greenenergyprojects/rpi-hot-water-controller/kicad/dist/rpi-hot-water-controller_image-top.png

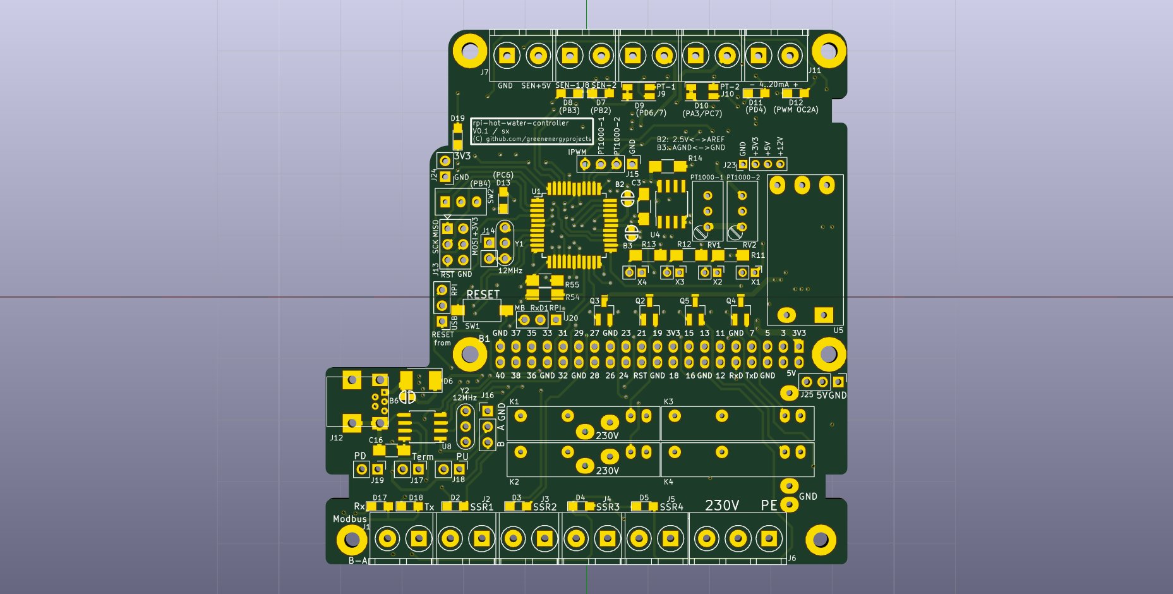
kicad/dist/rpi-hot-water-controller_image-top.png
