greenenergyprojects/rpi-hot-water-controller/kicad/dist/rpi-hot-water-controller_image-bottom.png

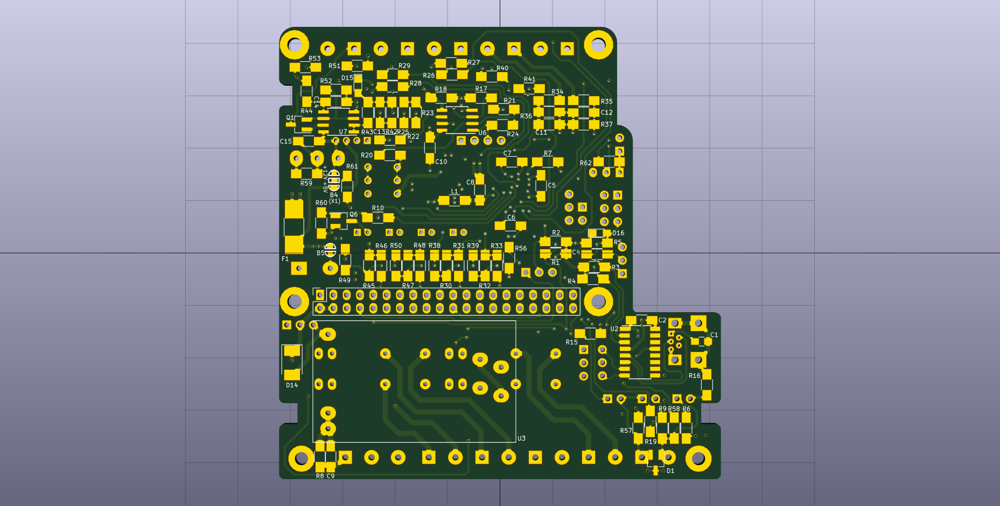
kicad/dist/rpi-hot-water-controller_image-bottom.png
