greenenergyprojects/rpi-hot-water-controller/kicad/README.md

https://rn-wissen.de/wiki/index.php/PTC/NTC#Schaltungsbeispiele
