greenenergyprojects/rpi-hot-water-controller/kicad/dist/rpi-hot-water-controller_bom.ods

Source: | /work/sx/gep/rpi-hot-water-controller/kicad/rpi-hot-water-controller.sch
Date: | Fr 12 Okt 2018 04:40:11 CEST
Tool: | Eeschema 4.0.7-e2-6376~61~ubuntu18.04.1
Component Count: | 159
Ref | Value | Footprint | Datasheet | Manufacturer | Vendor
B1 | SOLDERBRDIGE-3 | Pin_Headers:Pin_Header_Straight_1x03_Pitch2.54mm
B2 | SOLDERBRDIGE-2 | Project:SOLDER-JUMPER_1-WAY
B3 | SOLDERBRDIGE-2 | Project:SOLDER-JUMPER_1-WAY
B4 | SOLDERBRDIGE-3 | Project:SOLDER-JUMPER_2-WAY
B5 | SOLDERBRDIGE-2 | Project:SOLDER-JUMPER_1-WAY
B6 | SOLDERBRDIGE-2 | Project:SOLDER-JUMPER_1-WAY
C1 | 100n | Capacitors_SMD:C_0805_HandSoldering
C2 | 100n | Capacitors_SMD:C_1206_HandSoldering
C3 | 100n | Capacitors_SMD:C_1206_HandSoldering
C4 | 22n | Capacitors_SMD:C_1206_HandSoldering
C5 | 100n | Capacitors_SMD:C_1206_HandSoldering
C6 | 100n | Capacitors_SMD:C_1206_HandSoldering
C7 | 100n | Capacitors_SMD:C_1206_HandSoldering
C8 | 100n | Capacitors_SMD:C_1206_HandSoldering
C9 | 22n | Capacitors_SMD:C_1206_HandSoldering
C10 | 22n | Capacitors_SMD:C_1206_HandSoldering
C11 | 100n | Capacitors_SMD:C_1206_HandSoldering
C12 | 100n | Capacitors_SMD:C_1206_HandSoldering
C13 | 1u | Capacitors_SMD:C_1206_HandSoldering
C14 | 10u | Capacitors_SMD:C_1206_HandSoldering
C15 | 22n | Capacitors_SMD:C_1206_HandSoldering
C16 | 100n | Capacitors_SMD:C_1206_HandSoldering
D1 | D_TVS_x2_AAC-RESCUE-rpi-atmega324-modbus-x3-gateway | TO_SOT_Packages_SMD:SOT-23_Handsoldering
D2 | blue | LEDs:LED_0805_HandSoldering
D3 | blue | LEDs:LED_0805_HandSoldering
D4 | blue | LEDs:LED_0805_HandSoldering
D5 | blue | LEDs:LED_0805_HandSoldering
D6 | D_Schottky | Diodes_SMD:D_2114
D7 | green | LEDs:LED_0805_HandSoldering
D8 | green | LEDs:LED_0805_HandSoldering
D9 | PT1000-1 | Project:LED_Bi-Color-1206_ebay-381282302537
D10 | PT1000-2 | Project:LED_Bi-Color-1206_ebay-381282302537
D11 | green | LEDs:LED_0805_HandSoldering
D12 | blue | LEDs:LED_0805_HandSoldering
D13 | blue | LEDs:LED_0805_HandSoldering
D14 | D_Schottky | Diodes_SMD:D_2114
D15 | D_Schottky | LEDs:LED_0805_HandSoldering
D16 | D_Schottky | LEDs:LED_0805_HandSoldering
D17 | RX | LEDs:LED_0805_HandSoldering
D18 | TX | LEDs:LED_0805_HandSoldering
D19 | green | LEDs:LED_0805_HandSoldering
F1 | Polyfuse | Resistors_SMD:R_1812_HandSoldering
J1 | Modbus | Project:Terminalblock-2x-5,08mm_ebay-273426629807
J2 | SSR1 | Project:Terminalblock-2x-5,08mm_ebay-273426629807
J3 | SSR2 | Project:Terminalblock-2x-5,08mm_ebay-273426629807
J4 | SSR4 | Project:Terminalblock-2x-5,08mm_ebay-273426629807
J5 | SSR5 | Project:Terminalblock-2x-5,08mm_ebay-273426629807
J6 | Screw_Terminal_01x03 | Project:Terminalblock-3x-5mm_ebay-262602134567
J7 | SENSOR-SUPPLY | Project:Terminalblock-2x-5,08mm_ebay-273426629807
J8 | SENSOR-IN | Project:Terminalblock-2x-5,08mm_ebay-273426629807
J9 | PT1000-1 | Project:Terminalblock-2x-5,08mm_ebay-273426629807
J10 | PT1000-2 | Project:Terminalblock-2x-5,08mm_ebay-273426629807
J11 | 4-20mA | Project:Terminalblock-2x-5,08mm_ebay-273426629807
J12 | PRJ_USB_MINI | Project:USB_Mini-B-THT
J13 | Atmega-ISP-6 | Project:IDC_2x3x2.54mm_Straight
J14 | Conn_01x02 | Pin_Headers:Pin_Header_Straight_1x02_Pitch2.54mm
J15 | Conn_01x04 | Pin_Headers:Pin_Header_Straight_1x04_Pitch2.54mm
J16 | Conn_01x03 | Pin_Headers:Pin_Header_Straight_1x03_Pitch2.54mm
J17 | Conn_01x02 | Pin_Headers:Pin_Header_Straight_1x02_Pitch2.54mm
J18 | Conn_01x02 | Pin_Headers:Pin_Header_Straight_1x02_Pitch2.54mm
J19 | Conn_01x02 | Pin_Headers:Pin_Header_Straight_1x02_Pitch2.54mm
J20 | PRJ_Conn_01x03 | Pin_Headers:Pin_Header_Straight_1x03_Pitch2.54mm
J21 | Drill-1 | Mounting_Holes:MountingHole_2.5mm_Pad
J22 | Drill-2 | Mounting_Holes:MountingHole_2.5mm_Pad
J23 | Conn_01x04 | Pin_Headers:Pin_Header_Straight_1x04_Pitch2.00mm
J24 | TEST | Pin_Headers:Pin_Header_Straight_1x02_Pitch2.54mm
J25 | Conn_01x03 | Pin_Headers:Pin_Header_Straight_1x03_Pitch2.54mm
K1 | G3MB-202P | Project:SSR_Omron_G3MB-202P
K2 | G3MB-202P | Project:SSR_Omron_G3MB-202P
K3 | G3MB-202P | Project:SSR_Omron_G3MB-202P
K4 | G3MB-202P | Project:SSR_Omron_G3MB-202P
L1 | 10u | Inductors_SMD:L_1206_HandSoldering
P1 | PRJ_Raspberry_Pi_2+ | Project:PRJ_Raspberry-PI
Q1 | BSS138 | TO_SOT_Packages_SMD:SOT-23_Handsoldering
Q2 | BSS138 | TO_SOT_Packages_SMD:SOT-23_Handsoldering
Q3 | BSS138 | TO_SOT_Packages_SMD:SOT-23_Handsoldering
Q4 | BSS138 | TO_SOT_Packages_SMD:SOT-23_Handsoldering
Q5 | BSS138 | TO_SOT_Packages_SMD:SOT-23_Handsoldering
Q6 | BSS138 | TO_SOT_Packages_SMD:SOT-23_Handsoldering
R1 | 47k | Resistors_SMD:R_1206_HandSoldering
R2 | 47k | Resistors_SMD:R_1206_HandSoldering
R3 | 47k | Resistors_SMD:R_1206_HandSoldering
R4 | 47k | Resistors_SMD:R_1206_HandSoldering
R5 | 47k | Resistors_SMD:R_1206_HandSoldering
R6 | 560R | Resistors_SMD:R_1206_HandSoldering
R7 | 560R | Resistors_SMD:R_1206_HandSoldering
R8 | 100k | Resistors_SMD:R_1206_HandSoldering
R9 | 560R | Resistors_SMD:R_1206_HandSoldering
R10 | 220R | Resistors_SMD:R_1206_HandSoldering
R11 | 560R | Resistors_SMD:R_1206_HandSoldering
R12 | 560R | Resistors_SMD:R_1206_HandSoldering
R13 | 560R | Resistors_SMD:R_1206_HandSoldering
R14 | 330R | Resistors_SMD:R_1206_HandSoldering
R15 | 330R | Resistors_SMD:R_1206_HandSoldering
R16 | 330R | Resistors_SMD:R_1206_HandSoldering
R17 | 6k8 | Resistors_SMD:R_1206_HandSoldering
R18 | 8k2 | Resistors_SMD:R_1206_HandSoldering
R19 | 150R | Resistors_SMD:R_1206_HandSoldering
R20 | 2k7 | Resistors_SMD:R_1206_HandSoldering
R21 | 470R | Resistors_SMD:R_1206_HandSoldering
R22 | 6k8 | Resistors_SMD:R_1206_HandSoldering
R23 | 1k | Resistors_SMD:R_1206_HandSoldering
R24 | 15k | Resistors_SMD:R_1206_HandSoldering
R25 | 12k | Resistors_SMD:R_1206_HandSoldering
R26 | 820R | Resistors_SMD:R_1206_HandSoldering
R27 | 820R | Resistors_SMD:R_1206_HandSoldering
R28 | 820R | Resistors_SMD:R_1206_HandSoldering
R29 | 820R | Resistors_SMD:R_1206_HandSoldering
R30 | 220R | Resistors_SMD:R_1206_HandSoldering
R31 | 680R | Resistors_SMD:R_1206_HandSoldering
R32 | 220R | Resistors_SMD:R_1206_HandSoldering
R33 | 680R | Resistors_SMD:R_1206_HandSoldering
R34 | 4k7 | Resistors_SMD:R_1206_HandSoldering
R35 | 4k7 | Resistors_SMD:R_1206_HandSoldering
R36 | 8k2 | Resistors_SMD:R_1206_HandSoldering
R37 | 8k2 | Resistors_SMD:R_1206_HandSoldering
R38 | 47k | Resistors_SMD:R_1206_HandSoldering
R39 | 47k | Resistors_SMD:R_1206_HandSoldering
R40 | 680R | Resistors_SMD:R_1206_HandSoldering
R41 | 680R | Resistors_SMD:R_1206_HandSoldering
R42 | 3k3 | Resistors_SMD:R_1206_HandSoldering
R43 | 6k8 | Resistors_SMD:R_1206_HandSoldering
R44 | 15k | Resistors_SMD:R_1206_HandSoldering
R45 | 220R | Resistors_SMD:R_1206_HandSoldering
R46 | 680R | Resistors_SMD:R_1206_HandSoldering
R47 | 220R | Resistors_SMD:R_1206_HandSoldering
R48 | 680R | Resistors_SMD:R_1206_HandSoldering
R49 | 47k | Resistors_SMD:R_1206_HandSoldering
R50 | 47k | Resistors_SMD:R_1206_HandSoldering
R51 | 680R | Resistors_SMD:R_1206_HandSoldering
R52 | 120R | Resistors_SMD:R_1206_HandSoldering
R53 | 470 | Resistors_SMD:R_1206_HandSoldering
R54 | 47k | Resistors_SMD:R_1206_HandSoldering
R55 | 47k | Resistors_SMD:R_1206_HandSoldering
R56 | 47k | Resistors_SMD:R_1206_HandSoldering
R57 | 10R | Resistors_SMD:R_1206_HandSoldering
R58 | 10R | Resistors_SMD:R_1206_HandSoldering
R59 | 100k | Resistors_SMD:R_1206_HandSoldering
R60 | 47k | Resistors_SMD:R_1206_HandSoldering
R61 | 560R | Resistors_SMD:R_1206_HandSoldering
R62 | 680R | Resistors_SMD:R_1206_HandSoldering
RV1 | 1k | Potentiometers:Potentiometer_Trimmer_Bourns_3296W
RV2 | 1k | Potentiometers:Potentiometer_Trimmer_Bourns_3296W
SW1 | SW_Push | Project:PRJ_SW_SPST_FSMSM
SW2 | SW On/Off | Project:SW_ebay-171865305033
U1 | PRJ-UC-ATMEGA324P-20AU | Project:TQFP-44_10x10mm_Pitch0.8mm_Handsolded
U2 | CH340G | Project:SOIC-16_3.9x9.9mm_Pitch1.27mm_HANDSOLDERED
U3 | HLK-5M05 | Project:HLK_5M05
U4 | PRJ_LM336M-2.5 | Project:SOIC-8_3.9x4.9mm_Pitch1.27mm_Handsolded
U5 | PRJ-supply-5VtoPM12V_ebay-253052736386 | Project:ebay-253052736386
U6 | LM358 | Project:SOIC-8_3.9x4.9mm_Pitch1.27mm_Handsolded
U7 | LM358 | Project:SOIC-8_3.9x4.9mm_Pitch1.27mm_Handsolded
U8 | SN65HVD11 | Project:SOIC-8_3.9x4.9mm_Pitch1.27mm_Handsolded
X1 | EXT1 | Pin_Headers:Pin_Header_Straight_1x02_Pitch2.00mm
X2 | EXT2 | Pin_Headers:Pin_Header_Straight_1x02_Pitch2.00mm
X3 | EXT3 | Pin_Headers:Pin_Header_Straight_1x02_Pitch2.00mm
X4 | EXT4 | Pin_Headers:Pin_Header_Straight_1x02_Pitch2.00mm
Y1 | 12MHz | Crystals:Resonator-3pin_w7.0mm_h2.5mm
Y2 | 12MHz | Crystals:Resonator-3pin_w7.0mm_h2.5mm
