greenenergyprojects/rpi-hot-water-controller/kicad/dist/rpi-hot-water-controller_schematic-bw.pdf

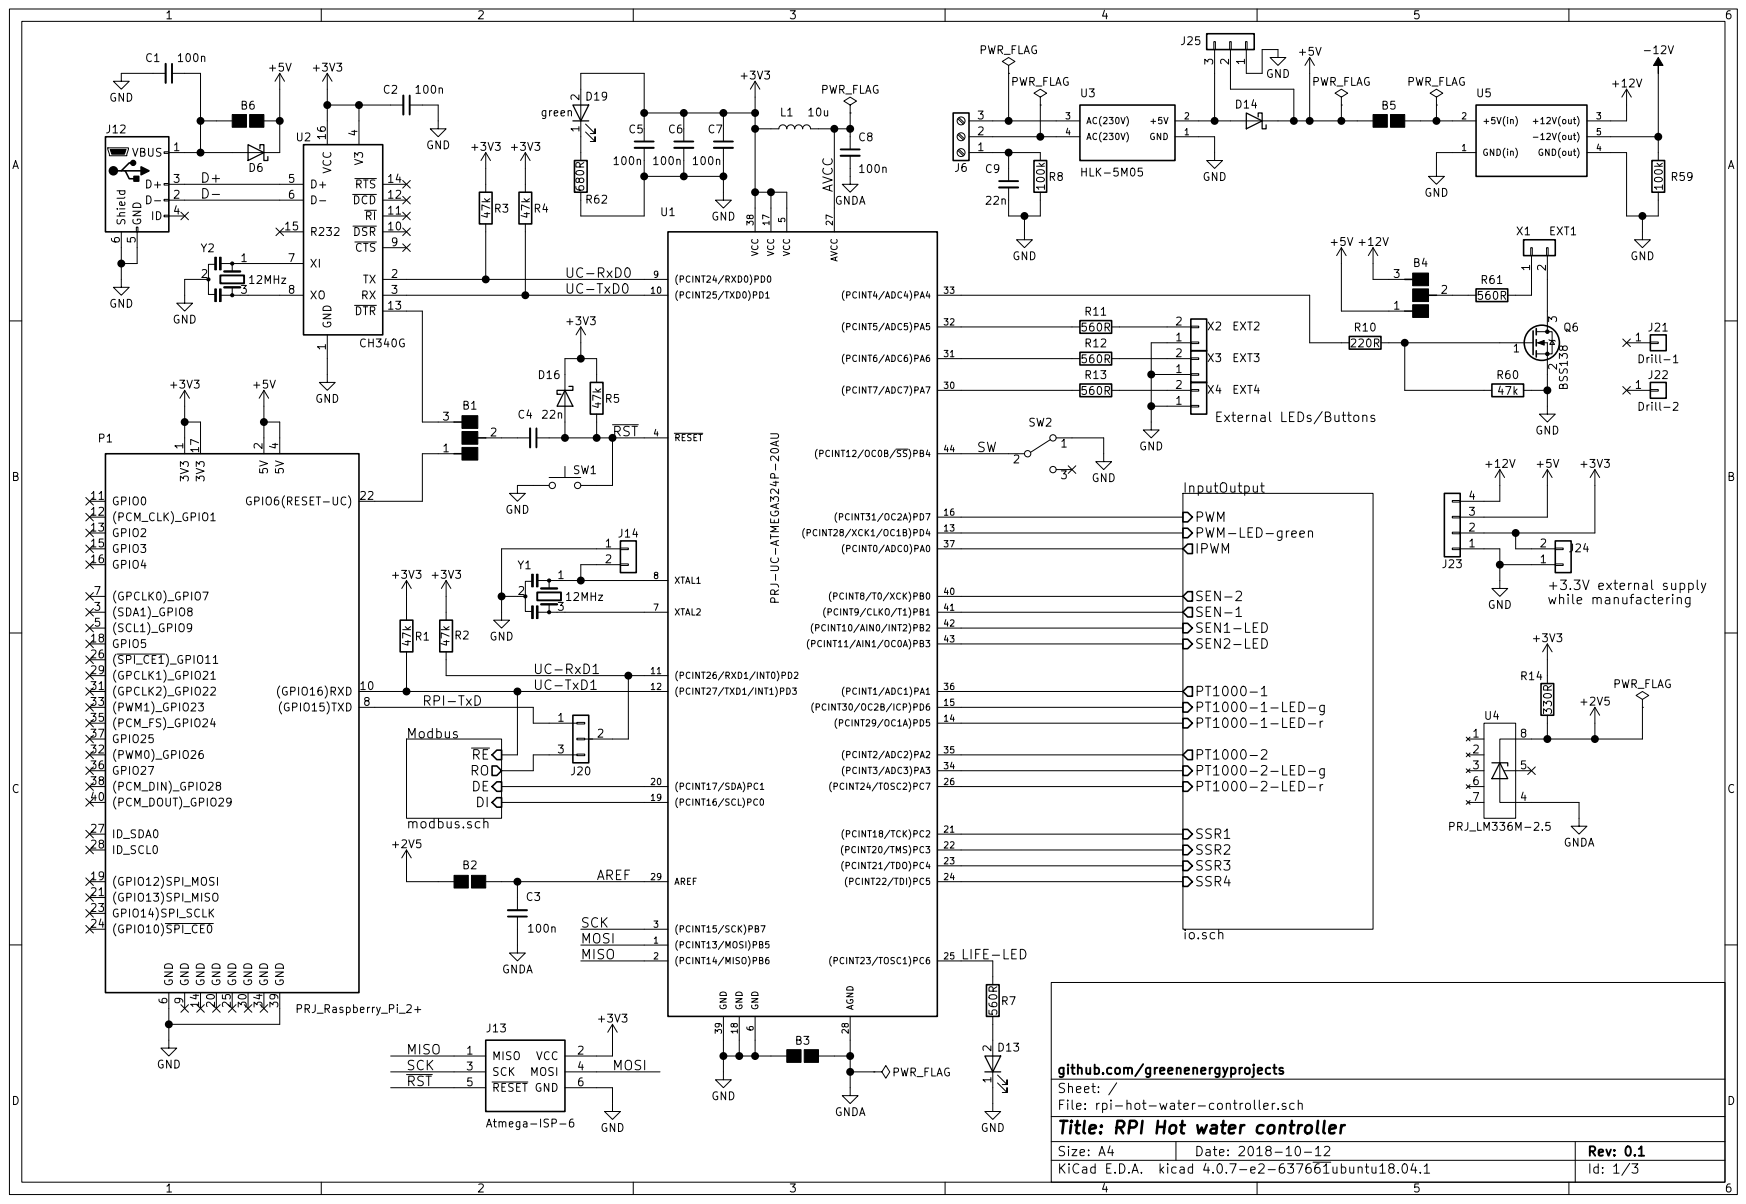
[picture p3: page 1]

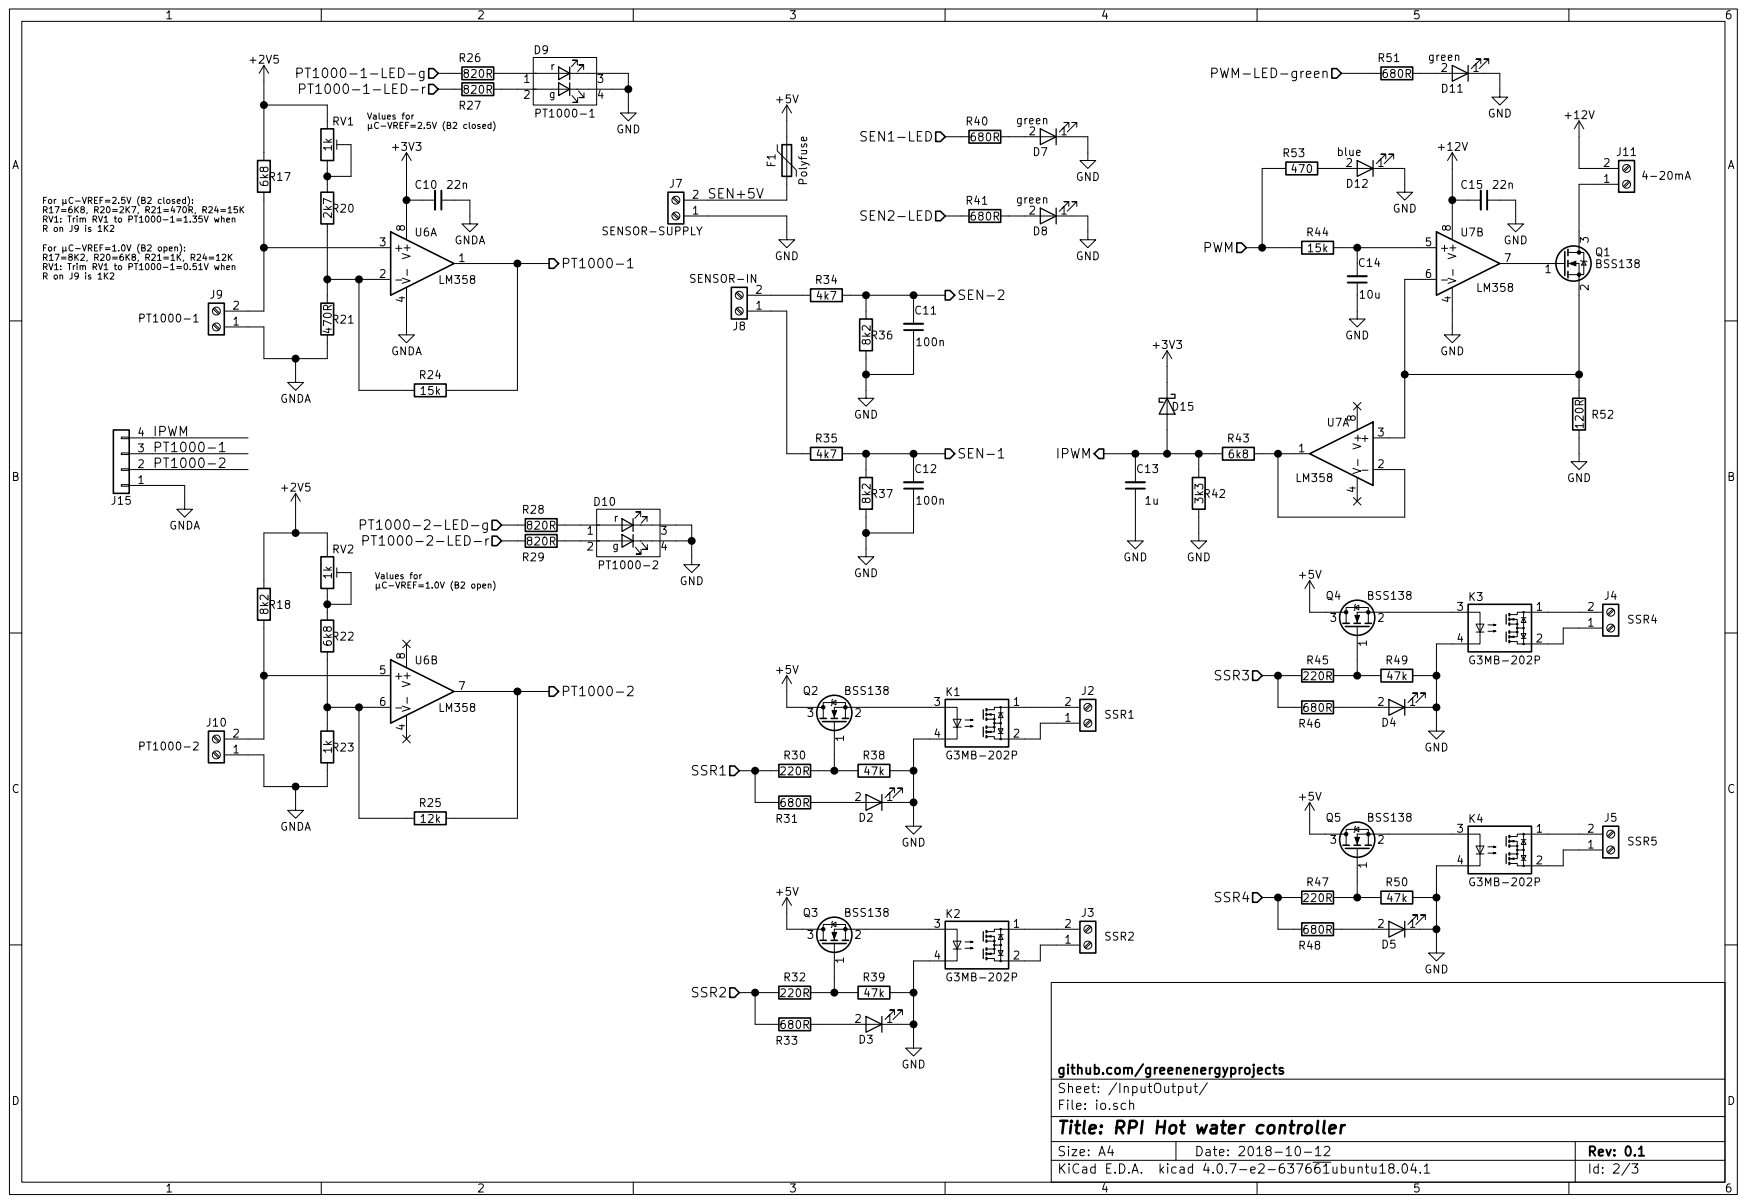
[picture p4: page 2]

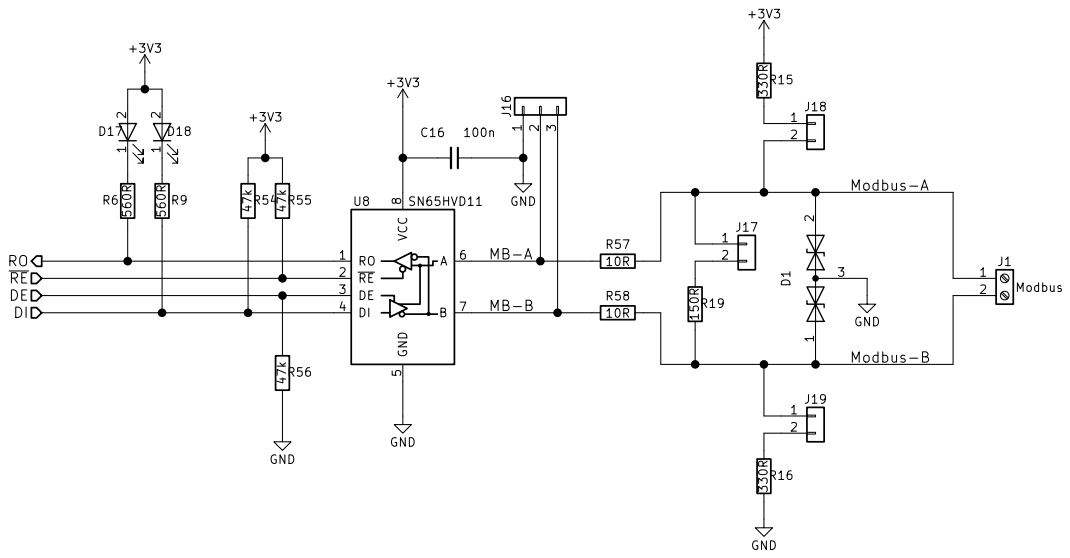
[picture p5: page 3]
