greenenergyprojects/rpi-hot-water-controller/kicad/dist/rpi-hot-water-controller_schematic.pdf

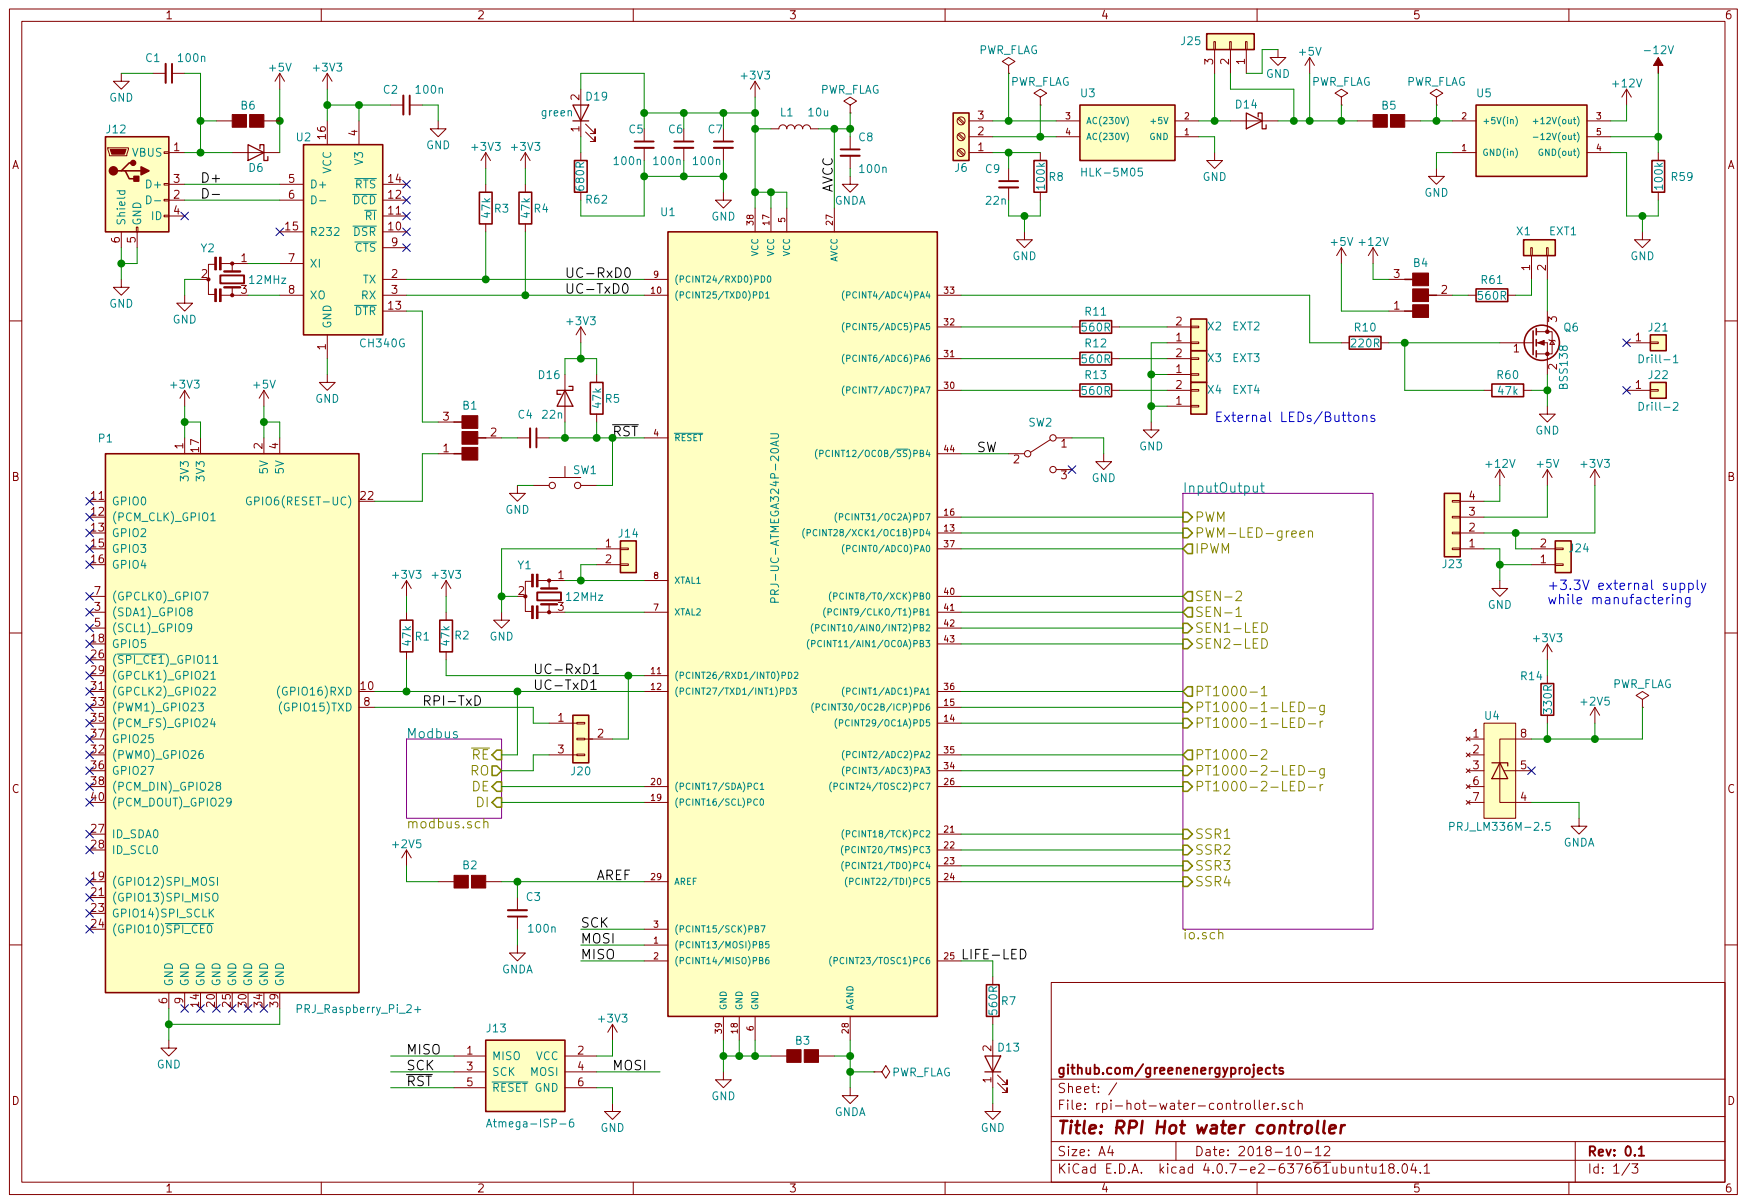
[picture p6: page 1]

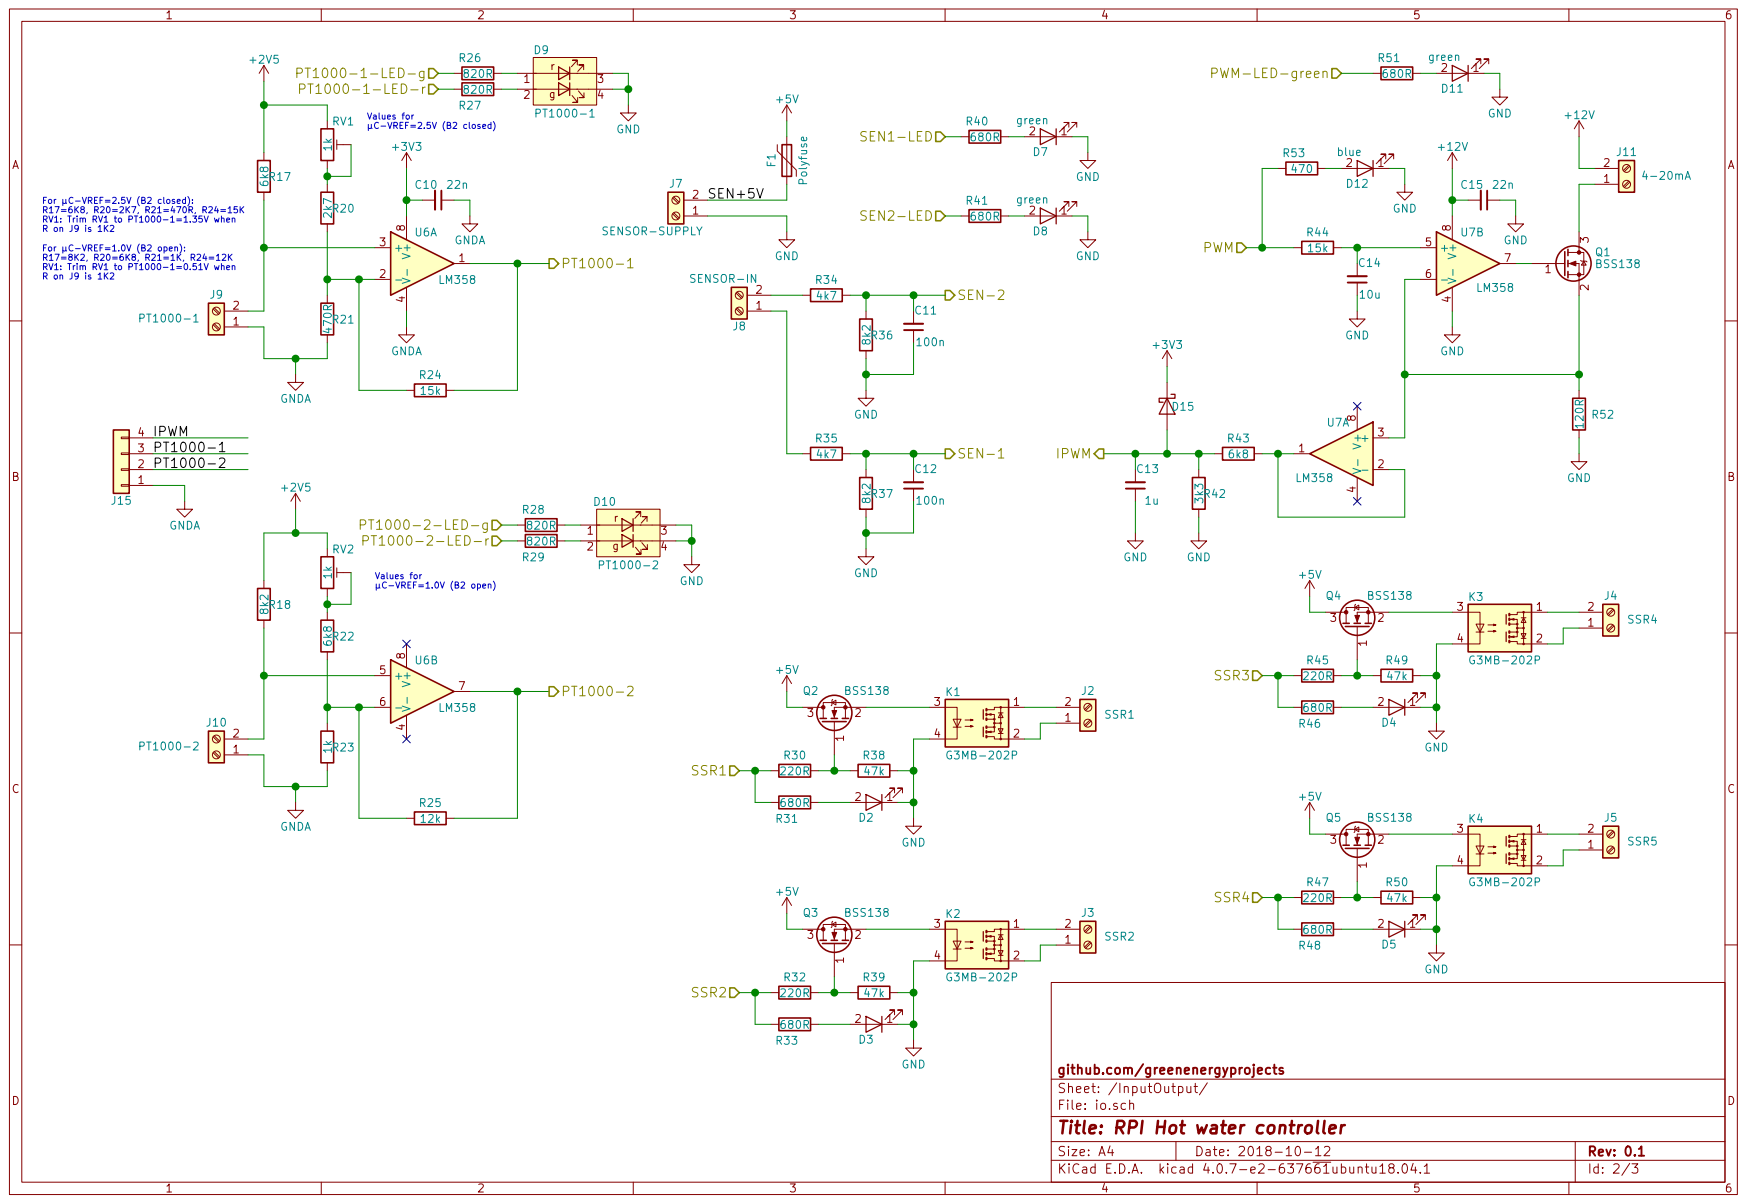
[picture p7: page 2]

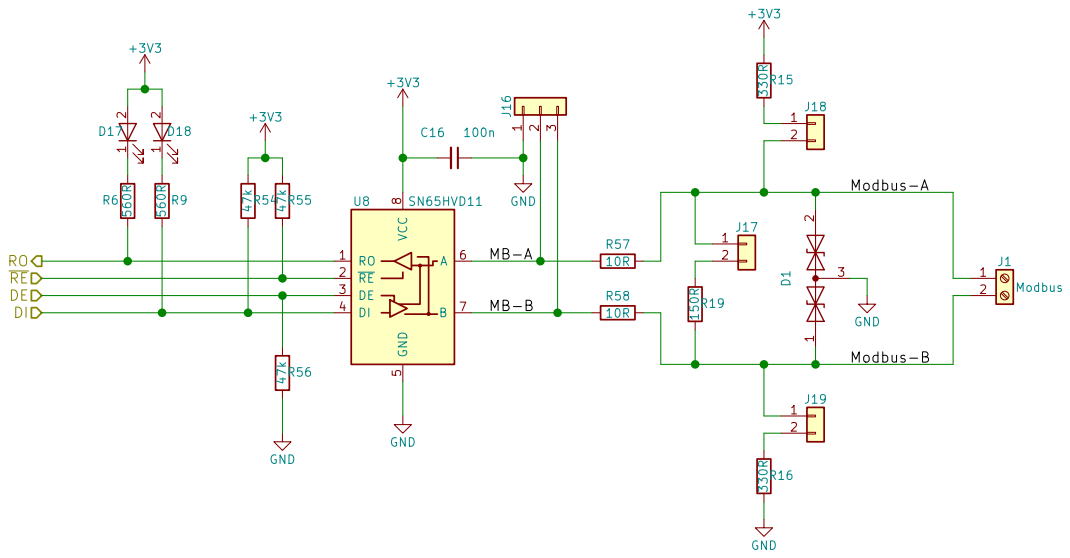
[picture p8: page 3]
