greenenergyprojects/rpi-hot-water-controller/kicad/rpi-hot-water-controller.kicad_pcb

## KiCad design kicad/rpi-hot-water-controller.kicad_pcb (2018-11-14)

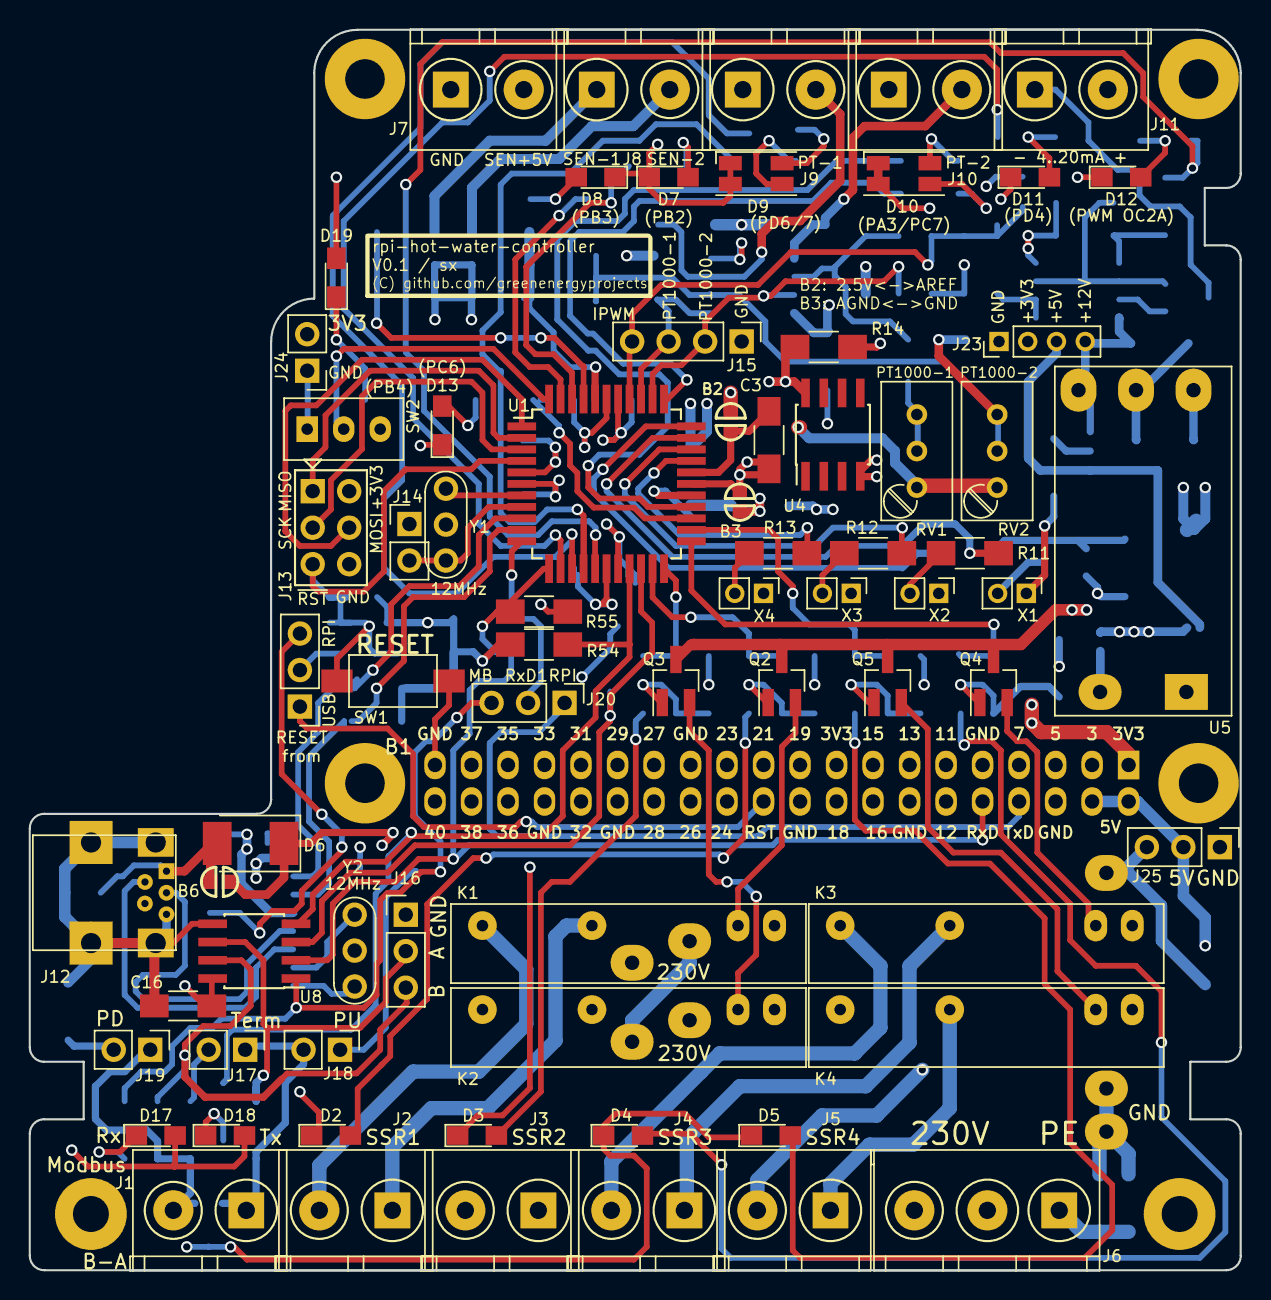
[picture p16: board rpi-hot-water-controller.kicad_pcb from above]

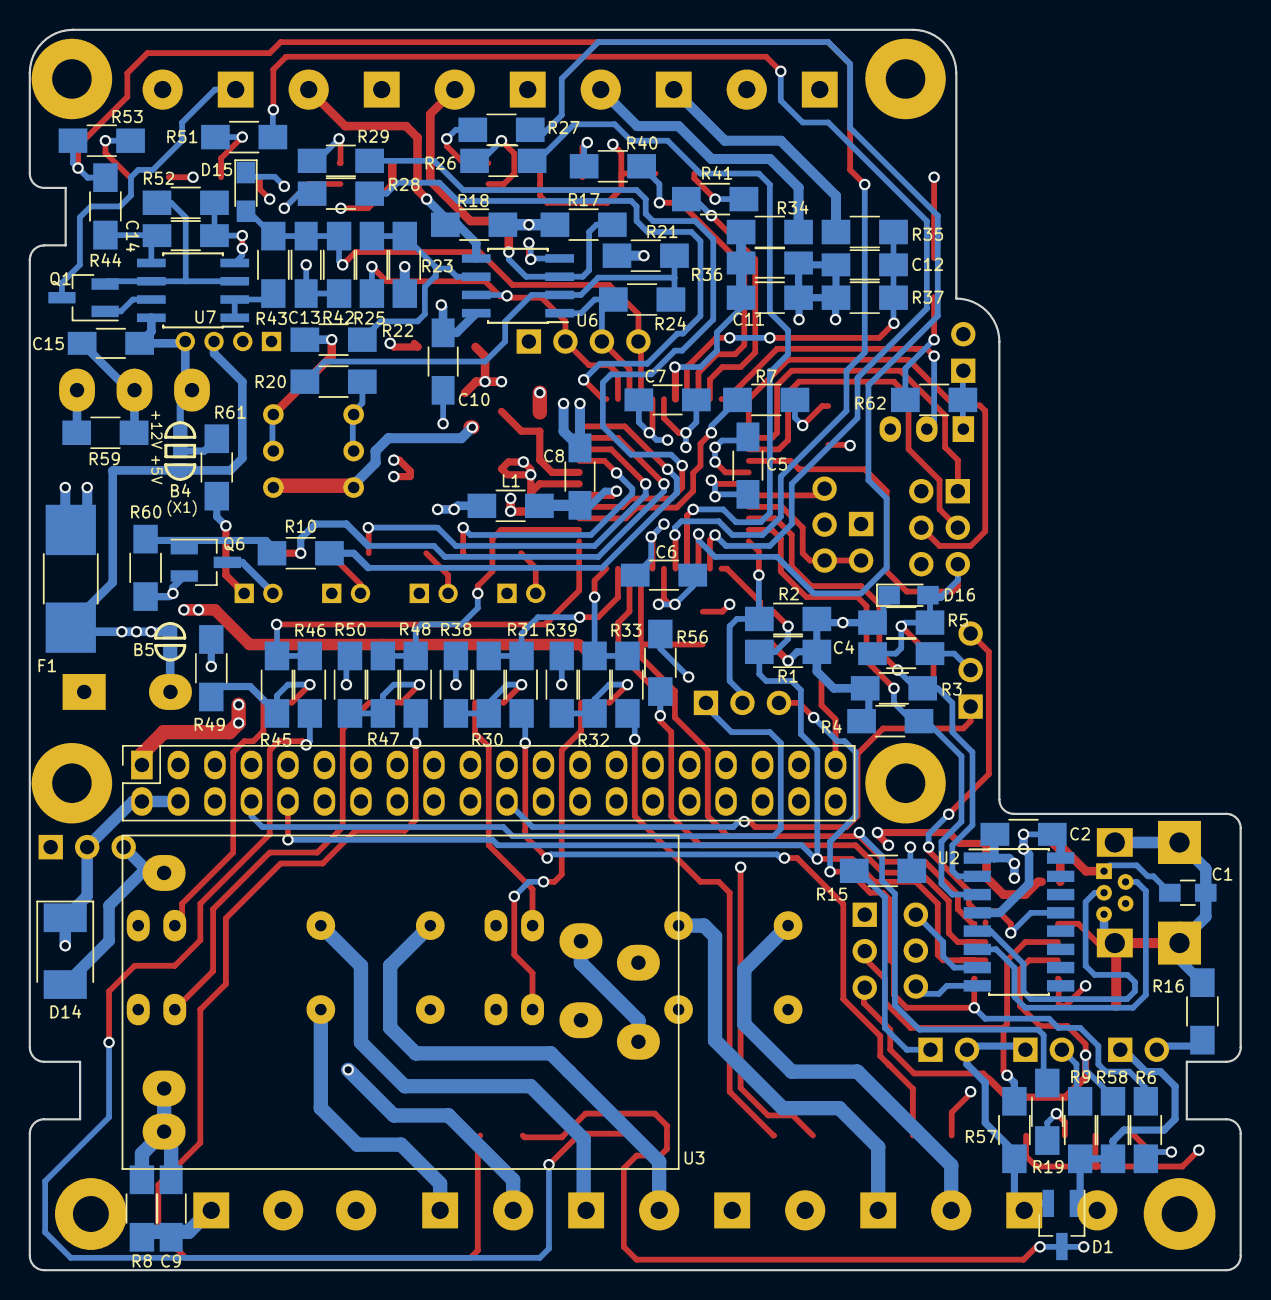
[picture p17: board rpi-hot-water-controller.kicad_pcb from below]

Board: 4 copper layers, 84.2 x 86.3 mm, 159 parts (84 on the bottom side), 119 nets.

Parts:
B1: SOLDERBRDIGE-3; Pin_Header_Straight_1x03_Pitch2.54mm
B2, B3, B5, B6: SOLDERBRDIGE-2; SOLDER-JUMPER_1-WAY
B4: SOLDERBRDIGE-3; SOLDER-JUMPER_2-WAY
C1: 100n; C_0805_HandSoldering
C2, C3, C5, C6, C7, C8, C11, C12, C16: 100n; C_1206_HandSoldering
C4, C9, C10, C15: 22n; C_1206_HandSoldering
C13: 1u; C_1206_HandSoldering
C14: 10u; C_1206_HandSoldering
D1: D_TVS_x2_AAC-RESCUE-rpi-atmega324-modbus-x3-gatew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; SOT-23_Handsoldering
D2, D3, D4, D5, D12, D13: blue; LED_0805_HandSoldering
D6, D14: D_Schottky; D_2114
D7, D8, D11, D19: green; LED_0805_HandSoldering
D9: PT1000-1; LED_Bi-Color-1206_ebay-381282302537
D10: PT1000-2; LED_Bi-Color-1206_ebay-381282302537
D15, D16: D_Schottky; LED_0805_HandSoldering
D17: RX; LED_0805_HandSoldering
D18: TX; LED_0805_HandSoldering
F1: Polyfuse; R_1812_HandSoldering
J1: Modbus; Terminalblock-2x-5,08mm_ebay-273426629807
J2: SSR1; Terminalblock-2x-5,08mm_ebay-273426629807
J3: SSR2; Terminalblock-2x-5,08mm_ebay-273426629807
J4: SSR4; Terminalblock-2x-5,08mm_ebay-273426629807
J5: SSR5; Terminalblock-2x-5,08mm_ebay-273426629807
J6: Screw_Terminal_01x03; Terminalblock-3x-5mm_ebay-262602134567
J7: SENSOR-SUPPLY; Terminalblock-2x-5,08mm_ebay-273426629807
J8: SENSOR-IN; Terminalblock-2x-5,08mm_ebay-273426629807
J9: PT1000-1; Terminalblock-2x-5,08mm_ebay-273426629807
J10: PT1000-2; Terminalblock-2x-5,08mm_ebay-273426629807
J11: 4-20mA; Terminalblock-2x-5,08mm_ebay-273426629807
J12: PRJ_USB_MINI; USB_Mini-B-THT
J13: Atmega-ISP-6; PRJ_Atmega-ISP-6
J14, J17, J18, J19: Conn_01x02; Pin_Header_Straight_1x02_Pitch2.54mm
J15: Conn_01x04; Pin_Header_Straight_1x04_Pitch2.54mm
J16, J25: Conn_01x03; Pin_Header_Straight_1x03_Pitch2.54mm
J20: PRJ_Conn_01x03; Pin_Header_Straight_1x03_Pitch2.54mm
J21: Drill-1; MountingHole_2.5mm_Pad
J22: Drill-2; MountingHole_2.5mm_Pad
J23: Conn_01x04; Pin_Header_Straight_1x04_Pitch2.00mm
J24: TEST; Pin_Header_Straight_1x02_Pitch2.54mm
K1, K2, K3, K4: G3MB-202P; SSR_Omron_G3MB-202P
L1: 10u; L_1206_HandSoldering
P1: PRJ_Raspberry_Pi_2+; PRJ_Raspberry-PI
Q1, Q2, Q3, Q4, Q5, Q6: BSS138; SOT-23_Handsoldering
R1, R2, R3, R4, R5, R38, R39, R49, R50, R54, R55, R56, R60: 47k; R_1206_HandSoldering
R6, R7, R9, R11, R12, R13, R61: 560R; R_1206_HandSoldering
R8, R59: 100k; R_1206_HandSoldering
R10, R30, R32, R45, R47: 220R; R_1206_HandSoldering
R14, R15, R16: 330R; R_1206_HandSoldering
R17, R22, R43: 6k8; R_1206_HandSoldering
R18, R36, R37: 8k2; R_1206_HandSoldering
R19: 150R; R_1206_HandSoldering
R20: 2k7; R_1206_HandSoldering
R21: 470R; R_1206_HandSoldering
R23: 1k; R_1206_HandSoldering
R24, R44: 15k; R_1206_HandSoldering
R25: 12k; R_1206_HandSoldering
R26, R27, R28, R29: 820R; R_1206_HandSoldering
R31, R33, R40, R41, R46, R48, R51, R62: 680R; R_1206_HandSoldering
R34, R35: 4k7; R_1206_HandSoldering
R42: 3k3; R_1206_HandSoldering
R52: 120R; R_1206_HandSoldering
R53: 470; R_1206_HandSoldering
R57, R58: 10R; R_1206_HandSoldering
RV1, RV2: 1k; Potentiometer_Trimmer_Bourns_3296W
SW1: SW_Push; PRJ_SW_SPST_FSMSM
SW2: SW On/Off; PRJ_SW_ebay-171865305033
U1: PRJ-UC-ATMEGA324P-20AU; TQFP-44_10x10mm_Pitch0.8mm_Handsolded
U2: CH340G; SOIC-16_3.9x9.9mm_Pitch1.27mm_HANDSOLDERED
U3: HLK-5M05; HLK_5M05_or_PM01
U4: PRJ_LM336M-2.5; SOIC-8_3.9x4.9mm_Pitch1.27mm_Handsolded
U5: PRJ-supply-5VtoPM12V_ebay-253052736386; ebay-253052736386
U6, U7: LM358; SOIC-8_3.9x4.9mm_Pitch1.27mm_Handsolded
U8: SN65HVD11; SOIC-8_3.9x4.9mm_Pitch1.27mm_Handsolded
X1: EXT1; Pin_Header_Straight_1x02_Pitch2.00mm
X2: EXT2; Pin_Header_Straight_1x02_Pitch2.00mm
X3: EXT3; Pin_Header_Straight_1x02_Pitch2.00mm
X4: EXT4; Pin_Header_Straight_1x02_Pitch2.00mm
Y1, Y2: 12MHz; Resonator-3pin_w7.0mm_h2.5mm

Connections:
+2V5: B2.1, R14.2, R17.1, R18.1, RV1.1, RV2.1, U4.8
+3V3: C2.2, C5.1, C6.1, C7.1, C10.2, C16.2, D15.1, D16.1, D17.2, D18.2, D19.2, J13.2, J23.2, J24.2, L1.1, P1.1, P1.17, R1.1, R2.2, R3.1, R4.1, R5.1, R14.1, R15.2, R54.2, R55.2, U1.5, U1.17, U1.38, U2.4, U2.16, U6.8, U8.8
+5V: B4.1, B5.2, B6.1, D6.1, D14.1, F1.1, J23.3, J25.2, P1.2, P1.4, Q2.3, Q3.3, Q4.3, Q5.3
+12V: B4.3, C15.2, J11.2, J23.4, U5.3, U7.8
-12V: R59.1, U5.5
/AREF: B2.2, C3.2, U1.29
/AVCC: C8.1, L1.2, U1.27
/D+: J12.3, U2.5
/D-: J12.2, U2.6
/InputOutput/IPWM: C13.2, D15.2, J15.4, R42.1, R43.2, U1.37
/InputOutput/PT1000-1: J15.3, R24.1, U1.36, U6.1
/InputOutput/PT1000-1-LED-g: R26.2, U1.15
/InputOutput/PT1000-1-LED-r: R27.2, U1.14
/InputOutput/PT1000-2: J15.2, R25.1, U1.35, U6.7
/InputOutput/PT1000-2-LED-g: R28.2, U1.34
/InputOutput/PT1000-2-LED-r: R29.2, U1.26
/InputOutput/PWM: R44.2, R53.2, U1.16
/InputOutput/PWM-LED-green: R51.2, U1.13
/InputOutput/SEN1-LED: R40.2, U1.42
/InputOutput/SEN2-LED: R41.2, U1.43
/InputOutput/SEN+5V: F1.2, J7.2
/InputOutput/SEN-1: C12.2, R35.1, R37.1, U1.41
/InputOutput/SEN-2: C11.2, R34.1, R36.1, U1.40
/InputOutput/SSR1: R30.2, R31.2, U1.21
/InputOutput/SSR2: R32.2, R33.2, U1.22
/InputOutput/SSR3: R45.2, R46.2, U1.23
/InputOutput/SSR4: R47.2, R48.2, U1.24
/LIFE-LED: R7.1, U1.25
/MISO: J13.1, U1.2
/MOSI: J13.4, U1.1
/Modbus/DE: R56.2, U1.20, U8.3
/Modbus/DI: R9.1, R54.1, U1.19, U8.4
/Modbus/MB-A: J16.2, R57.2, U8.6
/Modbus/MB-B: J16.3, R58.2, U8.7
/Modbus/Modbus-A: D1.2, J1.1, J17.1, J18.2, R57.1
/Modbus/Modbus-B: D1.1, J1.2, J19.1, R19.1, R58.1
/Modbus/RO: J20.3, R6.1, U8.1
/RPI-TxD: J20.1, P1.8
/SCK: J13.3, U1.3
/SW: SW2.2, U1.44
/UC-RxD0: R3.2, U1.9, U2.2
/UC-RxD1: J20.2, R2.1, U1.11
/UC-TxD0: R4.2, U1.10, U2.3
/UC-TxD1: P1.10, R1.2, R55.1, U1.12, U8.2
/~RST~: C4.1, D16.2, J13.5, R5.2, SW1.2, U1.4
GND: B3.2, C1.2, C2.1, C5.2, C6.2, C7.2, C9.2, C11.1, C12.1, C13.1, C14.1, C15.1, C16.1, D1.3, D2.1, D3.1, D4.1, D5.1, D7.1, D8.1, D9.3, D9.4, D10.3, D10.4, D11.1, D12.1, D13.1, J7.1, J12.5, J12.6, J13.6, J14.1, J16.1, J23.1, J24.1, J25.1, K1.4, K2.4, K3.4, K4.4, P1.6, P1.39, Q6.2, R8.2, R16.1, R36.2, R37.2, R38.1, R39.1, R42.2, R49.1, R50.1, R52.2, R56.1, R59.2, R60.1, R62.1, SW1.1, SW2.1, U1.6, U1.18, U1.39, U2.1, U3.1, U5.1, U5.4, U7.4, U8.5, X2.1, X3.1, X4.1, Y1.2, Y2.2
GNDA: B3.1, C3.1, C8.2, C10.1, J9.1, J10.1, J15.1, R21.2, R23.2, U1.28, U4.4, U6.4
unnamed: B1.1, P1.22
unnamed: B1.2, C4.2
unnamed: B1.3, U2.13
unnamed: B4.2, R61.2
unnamed: B5.1, U5.2
unnamed: B6.2, C1.1, D6.2, J12.1
unnamed: C9.1, J6.1, R8.1
unnamed: C14.2, R44.1, U7.5
unnamed: D2.2, R31.1
unnamed: D3.2, R33.1
unnamed: D4.2, R46.1
unnamed: D5.2, R48.1
unnamed: D7.2, R40.1
unnamed: D8.2, R41.1
unnamed: D9.1, R26.1
unnamed: D9.2, R27.1
unnamed: D10.1, R28.1
unnamed: D10.2, R29.1
unnamed: D11.2, R51.1
unnamed: D12.2, R53.1
unnamed: D13.2, R7.2
unnamed: D14.2, J25.3, U3.2
unnamed: D17.1, R6.2
unnamed: D18.1, R9.2
unnamed: D19.1, R62.2
unnamed: J2.1, K1.2
unnamed: J2.2, K1.1
unnamed: J3.1, K2.2
unnamed: J3.2, K2.1
unnamed: J4.1, K3.2
unnamed: J4.2, K3.1
unnamed: J5.1, K4.2
unnamed: J5.2, K4.1
unnamed: J6.2, U3.4
unnamed: J6.3, U3.3
unnamed: J8.1, R35.2
unnamed: J8.2, R34.2
unnamed: J9.2, R17.2, U6.3
unnamed: J10.2, R18.2, U6.5
unnamed: J11.1, Q1.3
unnamed: J14.2, U1.8, Y1.1
unnamed: J17.2, R19.2
unnamed: J18.1, R15.1
unnamed: J19.2, R16.2
unnamed: K1.3, Q2.2
unnamed: K2.3, Q3.2
unnamed: K3.3, Q4.2
unnamed: K4.3, Q5.2
unnamed: Q1.1, U7.7
unnamed: Q1.2, R52.1, U7.3, U7.6
unnamed: Q2.1, R30.1, R38.2
unnamed: Q3.1, R32.1, R39.2
unnamed: Q4.1, R45.1, R49.2
unnamed: Q5.1, R47.1, R50.2
unnamed: Q6.1, R10.1, R60.2
unnamed: Q6.3, X1.2
unnamed: R10.2, U1.33
unnamed: R11.1, X2.2
unnamed: R11.2, U1.32
unnamed: R12.1, X3.2
unnamed: R12.2, U1.31
unnamed: R13.1, X4.2
unnamed: R13.2, U1.30
unnamed: R20.1, RV1.2, RV1.3
unnamed: R20.2, R21.1, R24.2, U6.2
unnamed: R22.1, RV2.2, RV2.3
unnamed: R22.2, R23.1, R25.2, U6.6
unnamed: R43.1, U7.1, U7.2
unnamed: R61.1, X1.1
unnamed: U1.7, Y1.3
unnamed: U2.7, Y2.1
unnamed: U2.8, Y2.3
