greenenergyprojects/rpi-hot-water-controller/software/atmega324p_u1/hwc_u1/src/app.c

#include "global.h"
#include <stdio.h>
#include <string.h>

#include <avr/io.h>
#include <avr/interrupt.h>
#include <util/delay.h>

#include "app.h"
#include "sys.h"

// defines
#define test 0

// declarations and definations

struct App app;


// functions

void app_init (void) {
    memset((void *)&app, 0, sizeof(app));
    app.version = 1;
    app.sensor0Time = 0xffff;
}


//--------------------------------------------------------


// ------------------------------------------------------------------------

void app_test () {
    if (sys_isSw2On()) {
        sys_setLedPwmGreen(1);
        sys_setSSR(2, 1);
        sys_setSSR(3, 1);
        OCR2A = 0xff;
        sys_setLedPT1000Green(0, 1);
        sys_setLedPT1000Green(1, 1);
        sys_setLedPT1000Red(0, 0);
        sys_setLedPT1000Red(1, 0);
        // sys_setLedSensor1(1);
        // sys_setLedSensor2(0);

    } else {
        sys_setLedPwmGreen(0);
        sys_setSSR(2, 0);
        sys_setSSR(3, 0);
        sys_setLedPT1000Green(0, 0);
        sys_setLedPT1000Green(1, 0);
        sys_setLedPT1000Red(0, 1);
        sys_setLedPT1000Red(1, 1);
        // sys_setLedSensor1(0);
        // sys_setLedSensor2(1);

    }
}

void app_main (void) {
    if (test) {
        app_test();
    }
    app.curr4To20mAx2048 = (uint16_t)sys.adc0_u8 * 233 + 279; 
    if (app.curr4To20mAx2048 < (4 * 2048)) {
        app.pwmLedTimer = 0;
    } else {
        app.pwmLedTimer = 8000 / (app.curr4To20mAx2048 / 256);
    }
    // if (app.setpoint4To20mA > 0) {
    //     sys_setLedPwmGreen(1);
    // } else {
    //     sys_setLedPwmGreen(0);
    // }
}

uint16_t app_getSetpoint4To20mA () {
    return app.setpoint4To20mAx2028;
}

uint8_t app_setSetpoint4To20mA (uint16_t value) {
    app.setpoint4To20mAx2028 = value;
    uint32_t x1 = (uint32_t)value * 297 + 32768;
    uint16_t x2 = x1 >> 16;
    if (x2 > 255) { 
        x2 = 255;
    }
    sys_setPwm4To20mA(x2);
    return 0;
}

uint16_t app_getCurr4To20mA () {

    return app.curr4To20mAx2048;
}



//--------------------------------------------------------

void app_task_1ms (void) {
    static uint16_t timer = 0;
    if (timer <= 180) {
        timer = 1000;
    } else {
        timer--;
    }
    uint8_t x = app.curr4To20mAx2048 >> 8;
    if (x < 32) {
        sys_setLedPwmGreen(0);
    } else if (x > (20 * 8)) {
        sys_setLedPwmGreen(1);
    } else if (timer < (x * 25) / 4) {
        sys_setLedPwmGreen(1);
    } else {
        sys_setLedPwmGreen(0);
    }
}

void app_task_2ms (void) {
    static uint8_t oldS0 = 0;
    static uint16_t timer = 0;
    if (timer < 5000) {
        timer++;
    } else {
        app.sensor0Time = 0xffff;
    }
    if (sys_isSensor1On()) {
        sys_setLedSensor1(1); // S0 Energymeter
        oldS0 = 1;
    } else {
        sys_setLedSensor1(0);
        if (oldS0 == 1) {
            oldS0 = 0;
            if (app.sensor0Cnt < 0xffffffff) {
                app.sensor0Cnt++;
            }
            app.sensor0Time = timer;            
            timer = 0;
        }
    }

}

void app_task_4ms (void) {
    if (test) {
        sys_setLedSensor1(sys_isSensor1On());
        sys_setLedSensor2(sys_isSensor2On());
    }
}

void app_task_8ms (void) {
}


void app_task_16ms (void) {}

void app_task_32ms (void) {
    if (test) {
        static uint8_t timer = 0;
        OCR2A = timer++;
    }
}

void app_task_64ms (void) {
    if (sys_isSw2On()) {
        sys_toggleLifeLed();
    }
}

void app_task_128ms (void) {
    if (!sys_isSw2On()) {
        sys_toggleLifeLed();
    }
    if (sys_clearEvent(GLOBAL_EVENT_MODBUS_ASCII_FRAME)) {
        sys_setLedSensor2(1);
    } else {
        sys_setLedSensor2(0);
    }
    if (sys_clearEvent(GLOBAL_EVENT_MODBUS_ASCII_ERROR)) {
        sys_setLedPT1000Red(0, 1);
    } else {
        sys_setLedPT1000Red(0, 0);
    }
}
