greenenergyprojects/rpi-hot-water-controller/software/atmega324p_u1/hwc_u1/src/app.h

#ifndef APP_H_
#define APP_H_

// declarations


struct App_ErrCounter { // size word aligned !
    uint8_t modbus_ascii_lrc;
    uint8_t modbus_ascii_crlf;
};

struct App {
    uint8_t version;
    uint8_t debugLevel;
    struct App_ErrCounter err;
    uint16_t setpoint4To20mAx2028;
    uint16_t curr4To20mAx2048;
    uint8_t  pwmLedTimer;
    uint16_t sensor0Time;
    uint32_t sensor0Cnt;
};

extern struct App app;


// defines

// functions

void app_init ();
void app_main ();

uint8_t  app_setSetpoint4To20mA (uint16_t value);
uint16_t app_getSetpoint4To20mA ();
uint16_t app_getCurr4To20mA ();
uint32_t app_getSensor0Cnt ();


void app_task_1ms   ();
void app_task_2ms   ();
void app_task_4ms   ();
void app_task_8ms   ();
void app_task_16ms  ();
void app_task_32ms  ();
void app_task_64ms  ();
void app_task_128ms ();

#endif  // APP_H_
