greenenergyprojects/rpi-hot-water-controller/(commit log)

2018-10-05 first layout finished
    [io.sch, modbus.sch, rpi-hot-water-controller.kicad_pcb, rpi-hot-water-controller.sch]
2018-10-12 V0.1 Tapeout
    [io.sch, modbus.sch, rpi-hot-water-controller.kicad_pcb, rpi-hot-water-controller.sch, rpi-hot-water-controller_bom.ods]
2018-10-13 Tapeout V0.1 (gerber update)
    [rpi-hot-water-controller.kicad_pcb]
2018-11-14 test finished for pcb release V0.1
    [bridge_pt1000.ods, io.sch, rpi-hot-water-controller.kicad_pcb]
2018-12-03 4..20mA interface adjustments
2018-12-12 Bootloader for UART0+UART1
2019-01-18 µC S0 interface for energymeter, bugfix hangup
    [app.c, app.h, global.h, modbus.c, modbus_ascii.c, modbus_ascii.h, sys.c]
2020-03-05 V0.6.1 (fronius meter defect function)
    [io-2019-12-10-05-39-13.sch, modbus-2019-12-10-05-39-13.sch, rpi-hot-water-controller-2019-12-10-05-39-13.sch]
2021-01-14 controller improvement for battery full
